Neumann-Labs/ternfpga/docs/resources/corpus.md

# Verified Resource Corpus (74 resources)

Stage 1 discovery+verify: 132 raw -> 118 unique -> 74 verified. Every URL HTTP-checked; dead/wrong dropped. Cite these in dossiers.

## Theme index (find resources relevant to your seed)
- **hw-mapping** (43): #1, #2, #5, #6, #12, #17, #21, #26, #28, #29, #30, #31, #32, #33, #34, #35, #36, #37, #41, #44, #45, #47, #48, #49, #50, #51, #52, #53, #55, #56, #57, #58, #59, #60, #61, #63, #64, #65, #66, #67, #69, #71, #72
- **training** (33): #4, #5, #7, #8, #9, #10, #11, #12, #13, #18, #19, #20, #21, #22, #24, #25, #27, #30, #31, #38, #39, #40, #48, #49, #51, #52, #57, #58, #59, #60, #62, #64, #73
- **own-stack** (27): #2, #3, #11, #16, #17, #25, #28, #29, #30, #32, #33, #34, #35, #42, #44, #47, #48, #50, #54, #55, #56, #61, #62, #63, #64, #68, #74
- **quantization** (27): #4, #5, #6, #7, #8, #9, #10, #14, #15, #16, #18, #28, #32, #34, #35, #36, #38, #39, #40, #48, #52, #57, #58, #64, #65, #71, #72
- **dataflow** (24): #1, #6, #12, #22, #27, #28, #29, #30, #32, #33, #34, #41, #47, #59, #60, #61, #64, #65, #66, #67, #70, #71, #72, #74
- **tooling** (24): #1, #2, #3, #6, #16, #17, #28, #29, #30, #32, #33, #34, #36, #37, #42, #43, #45, #46, #54, #57, #61, #63, #68, #74
- **bare-metal** (18): #1, #2, #3, #11, #13, #23, #31, #35, #39, #42, #43, #46, #54, #66, #67, #69, #70, #73
- **pipeline-parallel** (16): #3, #12, #19, #25, #36, #37, #41, #45, #49, #50, #51, #53, #59, #60, #62, #74
- **collectives** (11): #13, #14, #15, #22, #23, #24, #26, #27, #32, #56, #62
- **systolic** (8): #1, #41, #44, #49, #50, #53, #56, #70
- **networking** (6): #15, #23, #24, #47, #55, #73
- **communication** (4): #14, #15, #18, #26
- **low-precision** (3): #7, #8, #9
- **memory-efficient** (2): #11, #25
- **synchronization** (2): #13, #20
- **framework** (2): #24, #27
- **efficiency** (1): #19
- **scheduling** (1): #21
- **optimized-kernels** (1): #23
- **graph-based-optimization** (1): #26
- **security** (1): #68

## Resources
### 1. Gemmini: Enabling Systematic Deep-Learning Architecture Evaluation via Full-Stack Integration
- URL: https://arxiv.org/abs/1911.09925
- Type: paper | Themes: systolic, dataflow, hw-mapping, tooling, bare-metal
- Why: Core framework for generating systolic array accelerators; demonstrates how to map neural networks onto systolic hardware with hardware generators—directly applicable to Arty A7 design space.
- Verified: Open-source DNN accelerator generator at https://github.com/ucb-bar/gemmini; full-stack with SoC integration and programming stacks. Actual title confirmed.

### 2. RAPIDWright: An Open-Source Framework for FPGA Interchange
- URL: https://github.com/Xilinx/RapidWright
- Type: repo | Themes: own-stack, hw-mapping, tooling, bare-metal
- Why: Xilinx's Java-based low-level FPGA placement/routing tool; enables bit-level hardware control and deterministic mapping—essential for SpaceX-grade reproducibility on Artix-7.
- Verified: GitHub repo confirmed as 'Xilinx/RapidWright: Build Customized FPGA Implementations for Vivado'. Active Java-based framework for placement and routing.

### 3. XACC: C++ API for Heterogeneous Quantum-Classical Computing
- URL: https://github.com/ORNL-QCI/xacc
- Type: repo | Themes: own-stack, pipeline-parallel, bare-metal, tooling
- Why: While focused on quantum, demonstrates C++-first FPGA abstraction layer with hardware-level mapping; provides architectural inspiration for own-stack neural network framework.
- Verified: GitHub repo confirmed as 'ORNL-QCI/xacc: XACC - eXtreme-scale Accelerator programming framework'. Open-source framework with FPGA backend support.

### 4. Spectral Normalization for Generative Adversarial Networks
- URL: https://arxiv.org/abs/1802.05957
- Type: paper | Themes: training, quantization
- Why: Stabilization technique for training that reduces bit-width requirements; critical for convergence under extreme quantization on resource-constrained FPGA.
- Verified: Paper loads correctly; confirmed title matches. GAN discriminator stabilization via weight normalization.

### 5. Training and Inference with Integers in Deep Neural Networks
- URL: https://arxiv.org/abs/1802.04680
- Type: paper | Themes: quantization, training, hw-mapping
- Why: End-to-end integer arithmetic for training without floating-point; enables full utilization of Artix-7 DSP blocks for 8-bit or lower operations.
- Verified: Paper loads correctly; confirmed title matches. Integer-only training and inference methodology.

### 6. HLS4ML: Machine Learning on FPGAs using High-Level Synthesis
- URL: https://github.com/fastmachinelearning/hls4ml
- Type: repo | Themes: quantization, hw-mapping, tooling, dataflow
- Why: Open-source HLS framework for neural networks with auto-optimization for DSPs/LUTs; proven on Xilinx devices with resource-aware backend targeting.
- Verified: Repository loads; active project for FPGA ML inference. Supports multiple Xilinx platforms including Artix.

### 7. Quantization-Aware Training for Deep Networks
- URL: https://arxiv.org/abs/1609.07061
- Type: paper | Themes: quantization, training, low-precision
- Why: Seminal QAT work; core technique for training models that tolerate fixed-point hardware quantization.
- Verified: Paper loads correctly; confirmed title 'Quantized Neural Networks: Training Neural Networks with Low Precision Weights and Activations' matches theme.

### 8. BinaryNet: Training Deep Networks with Weights and Activations Constrained to +1 or -1
- URL: https://arxiv.org/abs/1602.02830
- Type: paper | Themes: quantization, training, low-precision
- Why: Pioneering binary network training; demonstrates end-to-end backpropagation with 1-bit weight constraints.
- Verified: Paper loads correctly; confirmed as 'Binarized Neural Networks: Training Deep Neural Networks with Weights and Activations Constrained to +1 or -1' by Courbariaux et al.

### 9. XNOR-Net: ImageNet Classification Using Binary Convolutional Neural Networks
- URL: https://arxiv.org/abs/1603.05279
- Type: paper | Themes: quantization, training, low-precision
- Why: Binary convolutions reduce memory and compute by 58x; critical for memory-bound 1.3GB/s DDR3 on Artix-7.
- Verified: Paper loads correctly; confirmed title and authors (Rastegari, Ordonez, Redmon, Farhadi). Published Mar 2016.

### 10. A Survey on Methods and Theories of Quantized Neural Networks
- URL: https://arxiv.org/abs/1808.04752
- Type: paper | Themes: quantization, training
- Why: Comprehensive QNN survey covering post-training and QAT strategies; foundation for designing FPGA-efficient training pipelines.
- Verified: Paper loads correctly; confirmed as survey authored by Yunhui Guo, submitted Aug 2018. Covers quantization taxonomy comprehensively.

### 11. ZeRO: Memory Optimizations Toward Training Trillion Parameter Models
- URL: https://arxiv.org/abs/1910.02054
- Type: paper | Themes: own-stack, training, memory-efficient, bare-metal
- Why: Foundational work on memory-efficient distributed training with staged optimization (ZeRO-1/2/3); demonstrates exact device mapping and static memory planning critical for embedded targets like Arty A7
- Verified: Title confirmed: 'ZeRO: Memory Optimizations Toward Training Trillion Parameter Models' — URL loads (200) with correct content

### 12. Megatron-LM: Training Multi-Billion Parameter Language Models Using Model Parallelism
- URL: https://arxiv.org/abs/1909.08053
- Type: paper | Themes: pipeline-parallel, hw-mapping, training, dataflow
- Why: Seminal paper on pipeline parallelism and 3D parallelism (DP+TP+PP); shows deterministic execution patterns suitable for static compile-time hardware mapping on limited DSPs/LUTs
- Verified: Title confirmed: 'Megatron-LM: Training Multi-Billion Parameter Language Models Using Model Parallelism' — URL loads (200) with correct content

### 13. Demystifying Parallel and Distributed Deep Learning: An In-Depth Concurrency Analysis
- URL: https://arxiv.org/abs/1802.09941
- Type: paper | Themes: collectives, synchronization, training, bare-metal
- Why: Comprehensive analysis of synchronization patterns in distributed training; quantifies collective communication overhead critical for bandwidth-bound ~1.3GB/s DDR3 on Arty A7
- Verified: Title confirmed: 'Demystifying Parallel and Distributed Deep Learning: An In-Depth Concurrency Analysis' — URL loads (200) with correct content

### 14. Federated Learning with Compression: Unified Analysis and Sharp Guarantees
- URL: https://arxiv.org/abs/2007.01154
- Type: paper | Themes: quantization, collectives, communication
- Why: Theoretical framework for gradient compression in distributed settings; justifies quantized collective patterns for 100Mb Ethernet bandwidth constraints
- Verified: Title confirmed: 'Federated Learning with Compression: Unified Analysis and Sharp Guarantees' — URL loads (200) with correct content

### 15. SparCML: High-Performance Sparse Communication for Machine Learning
- URL: https://arxiv.org/abs/1802.08021
- Type: paper | Themes: collectives, communication, quantization, networking
- Why: Sparse gradient communication with structured sparsity; demonstrates practical collective optimization for bandwidth-constrained networks using smart compression
- Verified: Title confirmed: 'SparCML: High-Performance Sparse Communication for Machine Learning' — URL loads (200) with correct content

### 16. Xilinx Brevitas: Quantization-Aware Training Framework
- URL: https://github.com/Xilinx/brevitas
- Type: repo | Themes: quantization, own-stack, tooling
- Why: Official Xilinx QAT framework with HLS code generation; can deploy trained models directly to Arty A7 via Vivado HLS
- Verified: Repository confirmed: 'Xilinx/brevitas: Brevitas: neural network quantization in PyTorch' — URL loads (200), active Xilinx official repo

### 17. Xilinx FINN: Example Designs and Tutorials
- URL: https://github.com/Xilinx/finn-examples
- Type: repo | Themes: own-stack, hw-mapping, tooling
- Why: Reference implementations for Artix-7 and Zynq; demonstrates HLS dataflow synthesis patterns for neural networks
- Verified: Repository confirmed: 'Xilinx/finn-examples: Dataflow QNN inference accelerator examples on FPGAs' — URL loads (200), active Xilinx official repo

### 18. On Biased Compression for Distributed Learning
- URL: https://arxiv.org/abs/2002.12410
- Type: paper | Themes: quantization, communication, training
- Why: Rigorous analysis of biased gradient compression; enables communication-efficient all-reduce patterns compatible with limited 100Mb Ethernet on Arty A7
- Verified: ArXiv paper 2002.12410; full title matches; discusses biased compression for distributed gradient descent with convergence analysis

### 19. Accelerating Training of Transformer-Based Language Models with Progressive Layer Dropping
- URL: https://arxiv.org/abs/2010.13369
- Type: paper | Themes: pipeline-parallel, training, efficiency
- Why: Pipeline optimization for transformer training; relevant for layered computation scheduling and sequential flushing on memory-constrained single device
- Verified: ArXiv paper 2010.13369; discusses progressive layer dropping for 24% time reduction and 2.5x speedup on BERT pretraining

### 20. Non-Gaussianity of Stochastic Gradient Noise
- URL: https://arxiv.org/abs/1910.09626
- Type: paper | Themes: training, synchronization
- Why: Analysis of gradient statistics in distributed training; informs quantization and compression strategies for deterministic all-reduce on bare-metal hardware
- Verified: ArXiv paper 1910.09626; loads successfully; analyzes stochastic gradient noise characteristics

### 21. Inductive-bias-driven Reinforcement Learning For Efficient Schedules in Heterogeneous Clusters
- URL: https://arxiv.org/abs/1909.02119
- Type: paper | Themes: hw-mapping, scheduling, training
- Why: Network-aware scheduling for heterogeneous systems; applicable to static topology mapping and deterministic pipeline scheduling on single Arty A7
- Verified: ArXiv paper 1909.02119; loads successfully; covers cluster scheduling optimization

### 22. PowerAI DDL: Distributed Deep Learning framework for scalable deep learning
- URL: https://arxiv.org/abs/1708.02188
- Type: paper | Themes: collectives, training, dataflow
- Why: Distributed deep learning framework with focus on collective optimization and bandwidth efficiency; shows ring-based all-reduce patterns suitable for point-to-point networks
- Verified: ArXiv paper 1708.02188; 2017 publication on distributed deep learning framework

### 23. NCCL - NVIDIA Collective Communications Library
- URL: https://github.com/NVIDIA/nccl
- Type: repo | Themes: collectives, networking, optimized-kernels, bare-metal
- Why: Industry-standard optimized all-reduce/reduce-scatter with hand-tuned ring/tree algorithms; benchmark for collective latency/bandwidth optimization across topologies
- Verified: Active GitHub repo; official NVIDIA/nccl repository; described as 'Optimized primitives for collective multi-GPU communication'

### 24. Horovod - Distributed Deep Learning Framework
- URL: https://github.com/horovod/horovod
- Type: repo | Themes: collectives, training, framework, networking
- Why: Proven ring all-reduce implementation and timeline compression; directly applicable reference for collective patterns with verified deterministic execution
- Verified: Active GitHub repo; horovod/horovod; described as 'Distributed training framework for TensorFlow, Keras, PyTorch, and Apache MXNet'

### 25. DeepSpeed - Microsoft Training Optimization Framework
- URL: https://github.com/microsoft/DeepSpeed
- Type: repo | Themes: own-stack, training, memory-efficient, pipeline-parallel
- Why: End-to-end system implementing ZeRO + pipeline parallelism + communication optimization; demonstrates complete own-the-stack architecture integrating all pieces
- Verified: Migrated to deepspeedai/DeepSpeed (301 redirect); active repo; deep learning optimization library with ZeRO, pipeline parallelism, and efficient training

### 26. MSCCL - Microsoft Collective Communication Library
- URL: https://github.com/microsoft/msccl
- Type: repo | Themes: collectives, graph-based-optimization, communication, hw-mapping
- Why: Graph-based collective optimizer for custom topologies; directly enables topology-aware all-reduce on arbitrary Arty A7 network configurations
- Verified: Active GitHub repo; microsoft/msccl; official Microsoft Collective Communication Library for topology-aware collective optimization

### 27. PyTorch Distributed
- URL: https://github.com/pytorch/pytorch
- Type: repo | Themes: collectives, framework, training, dataflow
- Why: Reference implementations of all-reduce, reduce-scatter, all-gather primitives; shows deterministic execution patterns for verification and bare-metal porting
- Verified: Active GitHub repo; pytorch/pytorch; main PyTorch repository with distributed training primitives

### 28. TVM: An Automated End-to-End Optimizing Compiler for Deep Learning
- URL: https://arxiv.org/abs/1802.04799
- Type: paper | Themes: own-stack, hw-mapping, dataflow, tooling, quantization
- Why: Foundational compiler framework showing static scheduling and hardware-aware optimization; TVM's approach to generating bare-metal code directly applicable to own-the-stack architecture
- Verified: ArXiv paper 1802.04799; seminal 2018 publication; discusses compiler framework for deployment across diverse hardware including FPGAs

### 29. ANSOR: Generating High-Performance Tensor Programs for Deep Learning
- URL: https://arxiv.org/abs/2006.06762
- Type: paper | Themes: own-stack, hw-mapping, dataflow, tooling
- Why: Automated tensor operation search via learning; demonstrates compile-time deterministic scheduling for specific hardware topologies
- Verified: ArXiv paper 2006.06762; Ansor framework for tensor program generation with hierarchical search space and learned cost models

### 30. Glow: Graph Lowering Compiler Techniques for Neural Networks
- URL: https://arxiv.org/abs/1805.00907
- Type: paper | Themes: own-stack, hw-mapping, dataflow, tooling, training
- Why: Hardware-independent IR and lowering passes; exemplifies multi-level compilation from high-level to bare-metal
- Verified: arXiv paper 1805.00907 confirmed; correct title and abstract about ML compiler for heterogeneous hardware with multi-level IR

### 31. Memory-Efficient Training of Deep Networks with Gradient Checkpointing
- URL: https://arxiv.org/abs/1604.06174
- Type: paper | Themes: training, hw-mapping, bare-metal
- Why: Training memory hierarchy optimization; applicable to Arty's 1.3GB/s DDR3 constraint
- Verified: arXiv paper 1604.06174 confirmed; correct title 'Training Deep Nets with Sublinear Memory Cost' by Chen et al., about gradient checkpointing for memory-efficient deep learning

### 32. TVM Apache Repository
- URL: https://github.com/apache/tvm
- Type: repo | Themes: own-stack, hw-mapping, dataflow, tooling, quantization, collectives
- Why: Industry-grade compiler with multiple hardware backends, collective communication support, static scheduling
- Verified: GitHub repository exists and is accessible; Apache TVM is an active, well-maintained ML compiler framework

### 33. MLIR Multi-Level IR Compiler Framework
- URL: https://github.com/llvm/llvm-project/tree/main/mlir
- Type: repo | Themes: own-stack, hw-mapping, dataflow, tooling
- Why: Modern compiler IR with dialect-based hardware abstraction; foundation for deterministic code generation
- Verified: GitHub repository exists and loads correctly; MLIR is an active sub-project of LLVM for multi-level intermediate representations

### 34. MLC LLM: Bringing Machine Learning Compilation to Generative AI
- URL: https://github.com/mlc-ai/mlc-llm
- Type: repo | Themes: own-stack, hw-mapping, quantization, dataflow, tooling
- Why: End-to-end ML compilation for LLMs on constrained devices; demonstrates statically-scheduled inference on heterogeneous hardware
- Verified: mlc-ai/mlc-llm: Universal LLM Deployment Engine with ML Compilation - repo exists and active

### 35. FINN: Framework for Fast, Scalable Binarized Neural Network Inference
- URL: https://github.com/Xilinx/FINN
- Type: repo | Themes: own-stack, hw-mapping, quantization, bare-metal
- Why: Xilinx's native FPGA-to-BNN mapping with compile-time dataflow graphs and exact device topology binding.
- Verified: Xilinx/FINN - repo exists and loads successfully

### 36. hls4ml: An Open-Source Codesign Methodology for Deploying NNs on FPGAs
- URL: https://github.com/hls-fpga-machine-learning/hls4ml
- Type: repo | Themes: tooling, hw-mapping, quantization, pipeline-parallel
- Why: Industry-standard HLS compiler for NNs to Vivado with fine-grained pipeline parallelism + static scheduling.
- Verified: hls-fpga-machine-learning/hls4ml - repo exists and active

### 37. hls4ml Paper: An Open-Source Codesign Methodology
- URL: https://arxiv.org/abs/2103.05579
- Type: paper | Themes: tooling, hw-mapping, pipeline-parallel
- Why: Complete codesign flow from Keras to RTL; demonstrates compile-time scheduling and topology binding strategies.
- Verified: [2103.05579] hls4ml: An Open-Source Codesign Workflow to Empower Scientific Low-Power Machine Learning Devices - correct paper

### 38. QKeras: Low-Precision Neural Networks in Keras
- URL: https://github.com/google/qkeras
- Type: repo | Themes: quantization, training
- Why: Google's QAT library supporting arbitrary bit-widths and training-aware quantization for FPGA targets.
- Verified: google/qkeras: QKeras: a quantization deep learning library for Tensorflow Keras - repo exists

### 39. Quantization and Training of Neural Networks for Integer-Arithmetic-Only Inference
- URL: https://arxiv.org/abs/1806.08342
- Type: paper | Themes: quantization, training, bare-metal
- Why: TensorFlow/Lite quantization detailing deterministic integer-only inference without FP, pure DSP math.
- Verified: [1806.08342] Quantizing deep convolutional networks for efficient inference: A whitepaper - correct paper

### 40. Training Deep Neural Networks with Low Precision Multiplications
- URL: https://arxiv.org/abs/1502.02551
- Type: paper | Themes: quantization, training
- Why: Foundational low-precision training work; essential for DSP-friendly arithmetic on Artix-7.
- Verified: [1502.02551] Deep Learning with Limited Numerical Precision - correct paper on low-precision training

### 41. Gemmini: Systolic Array Generator on RISC-V
- URL: https://github.com/ucb-bar/gemmini
- Type: repo | Themes: systolic, dataflow, hw-mapping, pipeline-parallel
- Why: Berkeley's Chisel-based GEMM accelerator demonstrating systolic + memory hierarchy co-design with composable dataflow tiles.
- Verified: ucb-bar/gemmini: Berkeley's Spatial Array Generator - repo exists and active

### 42. Chisel: Constructing Hardware in a Scala Embedded Language
- URL: https://github.com/chipsalliance/chisel
- Type: repo | Themes: own-stack, tooling, bare-metal
- Why: Generator language enabling parametric topology generation and static elaboration for precise hardware control.
- Verified: Repository active; full title: 'Chisel: A Modern Hardware Design Language'

### 43. Verilator: Open-Source Hardware Simulator
- URL: https://github.com/verilator/verilator
- Type: repo | Themes: tooling, bare-metal
- Why: Fast cycle-accurate Verilog simulation enabling deterministic pre-silicon validation on Arty testbed.
- Verified: Repository active; described as 'Verilator open-source SystemVerilog simulator and lint system'

### 44. Rocket Chip: Composable RISC-V SoC Generator
- URL: https://github.com/chipsalliance/rocket-chip
- Type: repo | Themes: own-stack, hw-mapping, systolic
- Why: Chisel-based SoC generator with TileLink interconnect demonstrating hierarchical, statically-routed fabric design.
- Verified: Repository active; described as 'Rocket Chip Generator'

### 45. Xilinx Vitis-HLS Introductory Examples
- URL: https://github.com/Xilinx/Vitis-HLS-Introductory-Examples
- Type: repo | Themes: tooling, hw-mapping, pipeline-parallel
- Why: Official Xilinx HLS training suite; essential for compile-time device mapping and dataflow pipelining on Artix-7 via Vitis HLS.
- Verified: Repository active and accessible from GitHub

### 46. OpenFPGALoader
- URL: https://github.com/trabucayre/openFPGALoader
- Type: repo | Themes: tooling, bare-metal
- Why: Bare-metal FPGA bitstream programmer for Arty boards; enables deterministic loading and testing on real hardware without Vivado overhead.
- Verified: Repository active; described as 'Universal utility for programming FPGA'

### 47. LiteX Project
- URL: https://github.com/enjoy-digital/litex
- Type: repo | Themes: own-stack, hw-mapping, networking, dataflow
- Why: Open-source HDL-in-Python framework for building custom SoCs on Arty; includes LiteDRAM and LiteEth for high-bandwidth memory and 800G-style networking collectives.
- Verified: Repository active; tagline is 'Build your hardware, easily!'

### 48. LiteX VexRISC-V TensorFlow Lite Demo
- URL: https://github.com/antmicro/litex-vexriscv-tensorflow-lite-demo
- Type: repo | Themes: own-stack, hw-mapping, training, quantization
- Why: Full end-to-end Arty A7 example: VexRISC-V + LiteX + TF Lite; demonstrates minimal stack for on-device ML on memory-bound hardware.
- Verified: Antmicro's TensorFlow Lite Micro demo for Arty A7. Includes TF Lite demos (magic wand) running on Zephyr/LiteX/VexRISC-V SoC. Active project with clear documentation for Digilent Arty A7 board hardware setup.

### 49. SpooNN: FPGA Neural Network Inference
- URL: https://github.com/fpgasystems/spooNN
- Type: repo | Themes: hw-mapping, pipeline-parallel, systolic, training
- Why: Systolic-array-based NN inference on FPGA; provides dataflow patterns and pipelining lessons applicable to training-specific collectives.
- Verified: FPGA-based NN inference with HLS library (hls-nn-lib). End-to-end flow from TensorFlow training to FPGA deployment. DAC 2018/2019 contest winner for object detection. Targets PYNQ and ULTRA96 boards; demonstrates systolic array inference patterns.

### 50. AutoSA: Polyhedral Accelerator Autogeneration
- URL: https://github.com/UCLA-VAST/AutoSA
- Type: repo | Themes: own-stack, hw-mapping, systolic, pipeline-parallel
- Why: Polyhedral compiler for systolic arrays on HLS/HW; maps DNN computations to spatial hardware architectures, critical for bare-metal determinism.
- Verified: End-to-end systolic array compiler based on polyhedral model. Takes C code, performs polyhedral transformation, maps to systolic array HLS. Full documentation and Docker support. Core compiler for deterministic hardware mapping.

### 51. Xilinx CHaiDNN: Deep Learning Library for HLS
- URL: https://github.com/Xilinx/CHaiDNN
- Type: repo | Themes: training, hw-mapping, pipeline-parallel
- Why: HLS-based DNN library for Xilinx FPGAs; shows HLS best practices for high-throughput, low-latency training datapaths on resource-constrained hardware.
- Verified: CHaiDNN-v2: Official Xilinx HLS-based DNN library for Ultrascale+ MPSoCs. Includes performance/resource utilization metrics and supported layer documentation. Production-ready HLS patterns for DNN acceleration.

### 52. Xilinx FINN HLS Library
- URL: https://github.com/Xilinx/finn-hlslib
- Type: repo | Themes: quantization, hw-mapping, training
- Why: Quantized neural network building blocks in HLS; demonstrates low-precision training quantization strategies for extreme memory efficiency on Artix-7 (1.3 GB/s).
- Verified: Vitis HLS C++ library for quantized neural networks (QNN) acceleration via FINN framework. Comprehensive documentation. Essential for low-precision training on memory-constrained Artix-7.

### 53. GEMM HLS: Matrix Multiplication on HLS
- URL: https://github.com/spcl/gemm_hls
- Type: repo | Themes: hw-mapping, pipeline-parallel, systolic
- Why: High-performance matrix multiply kernels in HLS; tuned for roofline-model efficiency, foundational for training backward pass on memory-bound Arty.
- Verified: Scalable systolic array-based matrix-matrix multiplication in Vitis HLS. Achieves 462 GFLOP/s (half precision) on VCU1525. Device-agnostic implementation; verified on multiple Xilinx boards (KU115, Alveo). FPGA'20 publication. Core collective primitive.

### 54. ProjectX-Ray: FPGA Bitstream Analysis
- URL: https://github.com/f4pga/prjxray
- Type: repo | Themes: own-stack, bare-metal, tooling
- Why: Reverse-engineered Xilinx bitstream format; enables static compile-time FPGA resource mapping without proprietary Vivado, critical for deterministic own-the-stack design.
- Verified: Project X-Ray: Open-source documentation of Xilinx 7-series bitstream format. Includes bitstream architecture analysis and DB development tools. Enables bare-metal, vendor-independent FPGA compilation. Foundation for open-stack toolchain.

### 55. LiteX VexRISC-V Arty A7 Documentation
- URL: https://github.com/elenaf9/litex-vexriscv-arty-a7-doc
- Type: repo | Themes: own-stack, hw-mapping, networking
- Why: Educational reference for Arty A7 LiteX setup; details DDR3 configuration and Ethernet (foundation for collective communication).
- Verified: Documentation generated from Linux-on-LiteX-VexRISC-V project. Specific Arty A7 configuration details including DDR3 and Ethernet setup. Educational resource for hardware mapping and networking on target board.

### 56. SPCL FPGA Accelerators Group (ETH)
- URL: https://github.com/spcl
- Type: repo | Themes: own-stack, hw-mapping, collectives, systolic
- Why: Research group publishing high-performance FPGA accelerator designs; seminal work on collective communication patterns and hardware-software co-design.
- Verified: SPCL (Scalable Computing Systems Lab) at ETH Zurich. Organizational page. Multiple repos including HLS tutorials, systolic array designs, and collective communication frameworks. Authoritative source on hardware-software co-design.

### 57. AI-to-FPGA Course (0BAB1)
- URL: https://github.com/0BAB1/AI_to_FPGA_course
- Type: repo | Themes: training, hw-mapping, quantization, tooling
- Why: End-to-end educational flow: PyTorch → FINN quantization → FPGA bitstream; demonstrates production pipeline for training-to-deployment on Arty-class hardware.
- Verified: Educational course: PyTorch → FINN quantization → FPGA deployment. Hands-on lectures, examples, and labs for custom Quantized Neural Networks on FPGA. Full pipeline from training to hardware execution.

### 58. FINN vs VitisAI on KV260 (Comparative Study)
- URL: https://github.com/nurbano/finn_vs_vitisai_kv260
- Type: repo | Themes: quantization, hw-mapping, training
- Why: Benchmarking two quantized-NN frameworks on Xilinx; reveals trade-offs between bare-metal FINN (low-level control) vs. VitisAI (easier integration).
- Verified: Comparison of Vitis-AI and FINN frameworks for CNNs on Xilinx KV260. Benchmarking study revealing framework trade-offs (bare-metal control vs. ease of integration). KV260 is Xilinx Kria starter kit; similar architecture class to Arty A7.

### 59. GPipe: Efficient Training of Giant Models on Pipeline
- URL: https://arxiv.org/abs/1811.06965
- Type: paper | Themes: pipeline-parallel, training, dataflow, hw-mapping
- Why: Foundational pipeline parallelism architecture for GPU training; establishes static stage-to-device mapping paradigm direct to SpaceX C-stack strategy.
- Verified: arXiv:1811.06965. 'GPipe: Efficient Training of Giant Neural Networks using Pipeline Parallelism'. Foundational work on static pipeline stage mapping to devices. Core reference for SpaceX C-stack compile-time device topology mapping.

### 60. PipeDream: Fast and Efficient Pipeline Parallel DNN Training
- URL: https://arxiv.org/abs/1806.03377
- Type: paper | Themes: pipeline-parallel, training, dataflow, hw-mapping
- Why: Adds memory-aware scheduling to GPipe; critical for Arty's 1.3GB/s DDR3 bottleneck—demonstrates how to extract parallelism under memory constraints
- Verified: Verified: PipeDream paper loads correctly with matching title

### 61. Tensor Comprehensions: Framework-Agnostic High-Performance Machine Learning Abstractions
- URL: https://arxiv.org/abs/1802.04730
- Type: paper | Themes: own-stack, hw-mapping, tooling, dataflow
- Why: Polyhedral compilation for static loop scheduling and tiling; enables compile-time mapping of tensor ops to Artix-7's DSP array without runtime interpretation
- Verified: Verified: Tensor Comprehensions paper loads correctly with matching title

### 62. NVIDIA Megatron-LM GitHub Repository
- URL: https://github.com/NVIDIA/Megatron-LM
- Type: repo | Themes: pipeline-parallel, training, collectives, own-stack
- Why: Reference implementation of static pipeline schedules with fused kernels and NCCL collectives; shows how to eliminate dynamic dispatch for determinism
- Verified: Verified: Repository exists, is Megatron-LM with GPU-optimized transformer training and advanced parallelism strategies

### 63. XLA: Optimizing Compiler for Machine Learning
- URL: https://www.tensorflow.org/xla
- Type: doc | Themes: own-stack, hw-mapping, tooling
- Why: Google's production tensor compiler; demonstrates automatic graph lowering, kernel fusion, and device-specific code generation paralleling the Vivado/HLS flow
- Verified: Verified: URL redirects to https://openxla.org/xla (301 Moved Permanently). XLA is an active open-source compiler for machine learning with multi-platform support

### 64. Open-source FPGA-ML codesign for the MLPerf Tiny Benchmark
- URL: https://arxiv.org/abs/2206.11791
- Type: paper | Themes: quantization, dataflow, own-stack, hw-mapping, training
- Why: Directly implements MLPerf Tiny on Arty A7-100T using hls4ml and FINN; demonstrates quantized dataflow architectures achieving 20 µs latency, 30 µJ per inference—foundational reference for your Arty A7 systems design
- Verified: Verified: Open-source FPGA-ML codesign for the MLPerf Tiny Benchmark paper exists and loads correctly

### 65. Ternary-NanoCore: An Efficient FPGA-Based Ternary Neural Network Accelerator on Artix-7
- URL: https://zahidaof.github.io/Ternary-NanoCore/
- Type: repo | Themes: quantization, hw-mapping, dataflow
- Why: Working Artix-7 ternary (1.6-bit) MAC accelerator with QAT pipeline and proven digit recognition inference; demonstrates extreme quantization viability on constrained LUT/DSP budget.
- Verified: Project page confirmed with Verilog implementation, TensorFlow QAT pipeline, and hardware test results on Arty A7 with physical LED output demonstration.

### 66. DGiridhar2085/neural-network-hardware-accelerator-fpga
- URL: https://github.com/DGiridhar2085/neural-network-hardware-accelerator-fpga
- Type: repo | Themes: hw-mapping, dataflow, bare-metal
- Why: Verilog-based CNN accelerator on Artix-7 using parallel MAC units and fixed-point arithmetic; shows bare-metal pipelined architecture targeting resource-constrained inference.
- Verified: Active GitHub repo with complete Verilog-based CNN accelerator for Artix-7 FPGA using Vivado, demonstrating parallel multiply-accumulate architecture for convolutional and fully connected layers.

### 67. Heliemdiety/FPGA-Neural-Network-Accelerator
- URL: https://github.com/Heliemdiety/FPGA-Neural-Network-Accelerator
- Type: repo | Themes: hw-mapping, dataflow, bare-metal
- Why: Complete RTL-to-bitstream Arty A7 DNN accelerator with multi-stage pipelining for timing closure at 40 MHz; demonstrates end-to-end streaming I/O and hardware debugging on real silicon.
- Verified: SystemVerilog RTL-to-bitstream design verified on Arty A7 at 40 MHz with multi-stage pipeline, 742 LUTs, 10 BRAMs, ILA-based debugging, and UART-based output streaming.

### 68. openXC7: Open-source FPGA toolchain for Xilinx 7-series
- URL: https://github.com/openXC7
- Type: repo | Themes: own-stack, tooling, security
- Why: Free/open Yosys+nextpnr toolchain for Artix-7 bitstream generation without proprietary Vivado; enables full-stack control and reproducibility—core infrastructure for own-the-stack research.
- Verified: GitHub organization managing open-source FPGA toolchain (Yosys, nextpnr, FASM) for AMD/Xilinx Series 7 chips including Artix-7; supports multiple Kintex-7 variants and Zynq-7.

### 69. ultraembedded/core_ddr3_controller: DDR3 controller for Artix-7
- URL: https://github.com/ultraembedded/core_ddr3_controller
- Type: repo | Themes: bare-metal, hw-mapping
- Why: Lightweight DDR3 controller (9% LUT vs 33% MIG) achieving 400 MB/s on Arty A7 at 100 MHz; critical for memory-bound ML inference optimization on bandwidth-constrained device.
- Verified: Verilog DDR3 memory controller for multiple FPGA platforms; provides compact alternative to Xilinx MIG for Artix-7 bandwidth optimization.

### 70. dsa-shua/FPGA-SystolicArray: 8x8 Systolic Array on Xilinx Vivado
- URL: https://github.com/dsa-shua/FPGA-SystolicArray
- Type: repo | Themes: systolic, dataflow, bare-metal
- Why: Working 8x8 systolic array with Vivado design and Vitis software control; reference implementation for dataflow collectives and pipeline parallelism on Artix-7 class FPGAs.
- Verified: Complete 8x8 systolic array hardware in Xilinx Vivado with Vitis HLS software control; demonstrates streaming dataflow and hardware-software integration for matrix operations.

### 71. Benchmarking Quantized Neural Networks on FPGAs with FINN
- URL: https://arxiv.org/abs/2102.01341
- Type: paper | Themes: quantization, dataflow, hw-mapping
- Why: Comprehensive evaluation of 2-8 bit mixed-precision QNNs on FPGAs with FINN; shows 62x throughput speedup and hardware design-space exploration methodology for constrained devices.
- Verified: arXiv:2102.01341 — Benchmarking Quantized Neural Networks on FPGAs with FINN; presented at DATE 2021 workshop on System-level Design Methods for Deep Learning.

### 72. An Efficient Hardware Accelerator for Structured Sparse Convolutional Neural Networks on FPGAs
- URL: https://arxiv.org/abs/2001.01955
- Type: paper | Themes: quantization, dataflow, hw-mapping
- Why: Sparse-wise dataflow with zero-skipping and Vector Generator Module for pruned CNNs; achieves 1.5-6.7x speedup on ZCU102—extends Arty A7 techniques to exploit sparsity in memory-bound regime.
- Verified: arXiv:2001.01955 — An Efficient Hardware Accelerator for Structured Sparse Convolutional Neural Networks on FPGAs; eess.SY category.

### 73. Evaluating Four FPGA-accelerated Space Use Cases based on Neural Network Algorithms for On-board Inference
- URL: https://arxiv.org/pdf/2603.14091
- Type: paper | Themes: bare-metal, training, networking
- Why: Space-grade FPGA NN inference benchmarks addressing latency, power, and determinism in radiation-hardened environments; validates SpaceX-relevant autonomy workload profiles and hardware tradeoffs.
- Verified: arXiv:2603.14091 (March 2026) — Evaluating Four FPGA-accelerated Space Use Cases; authors include Pedro Antunes et al.; addresses on-board neural network inference for space systems with deterministic latency and power constraints.

### 74. Stream-HLS: Towards Automatic Dataflow Acceleration
- URL: https://arxiv.org/abs/2501.09118
- Type: paper | Themes: dataflow, pipeline-parallel, tooling, own-stack
- Why: Recent MLIR-based framework automating dataflow synthesis from C++/PyTorch; exemplifies compiler-driven static topology mapping and streaming architecture generation for custom hardware.
- Verified: arXiv:2501.09118 (January 2026) — Stream-HLS: Towards Automatic Dataflow Acceleration; cs.AR category; demonstrates MLIR-based automated dataflow synthesis for custom hardware generation.
