Neumann-Labs/ternfpga/bench/plots/ddr3_roofline.png

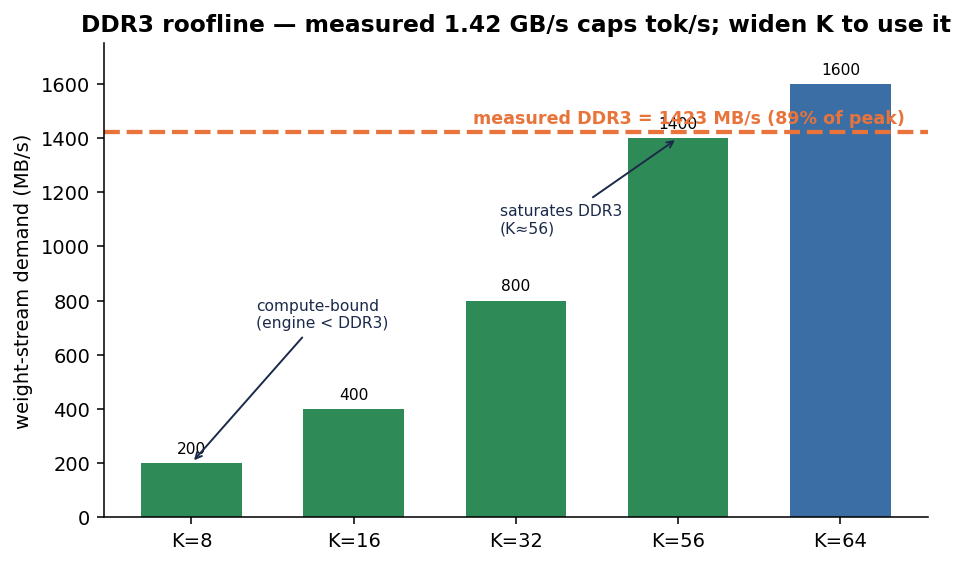
bench/plots/ddr3_roofline.png
