Neumann-Labs/ternfpga/bench/plots/ffn_block_energy.png

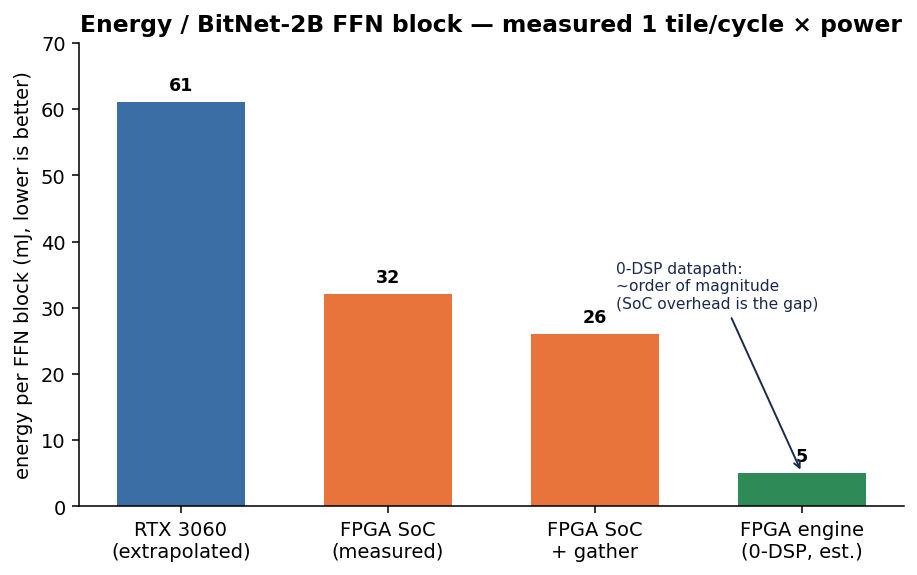
bench/plots/ffn_block_energy.png
