Neumann-Labs/ternfpga/bench/plots/full_model_energy.png

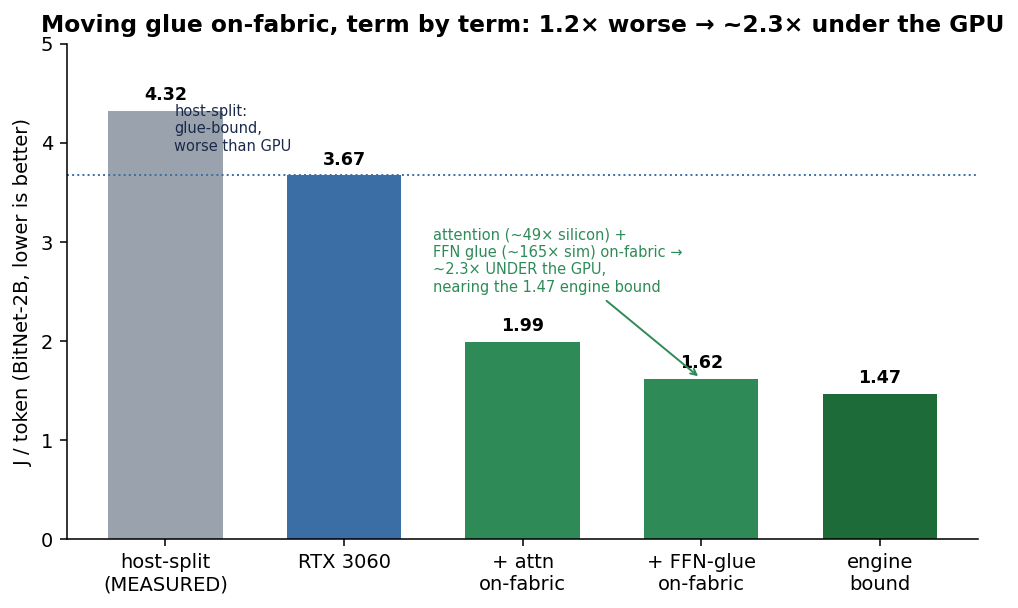
bench/plots/full_model_energy.png
