Neumann-Labs/ternfpga/bench/plots/gather_savings.png

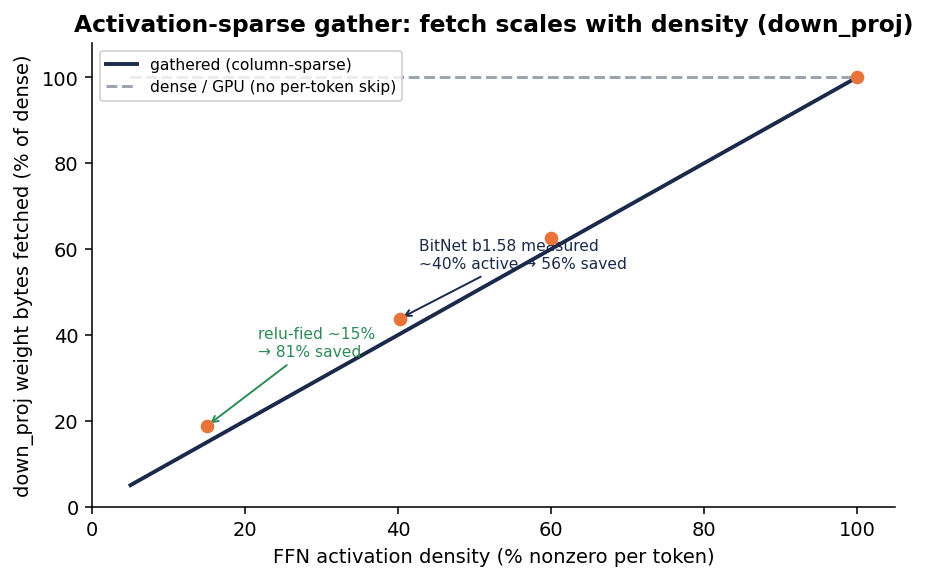
bench/plots/gather_savings.png
