Neumann-Labs/ternfpga/bench/plots/sparsity_compare.png

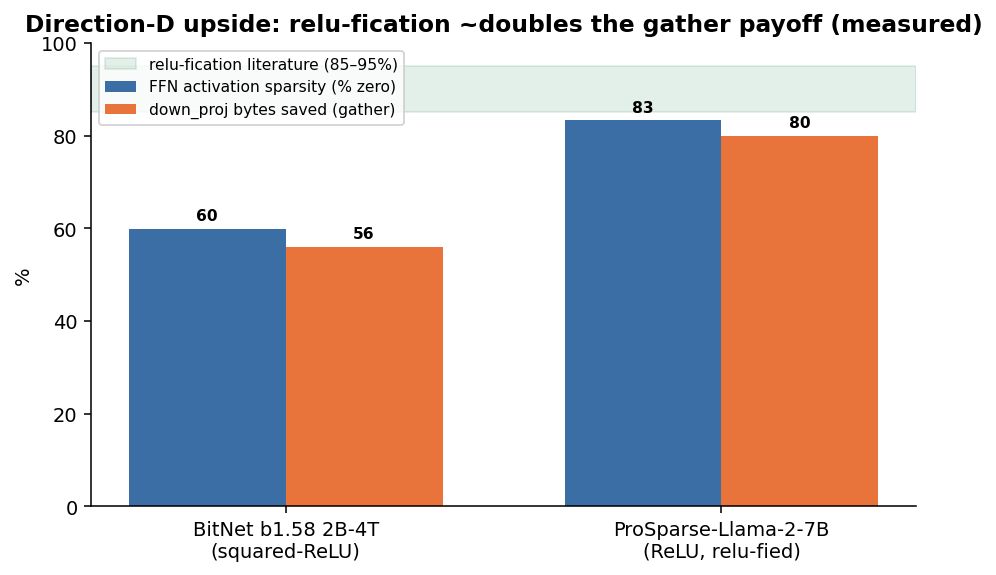
bench/plots/sparsity_compare.png
