Neumann-Labs/ternfpga/bench/plots/sparsity_structure.png

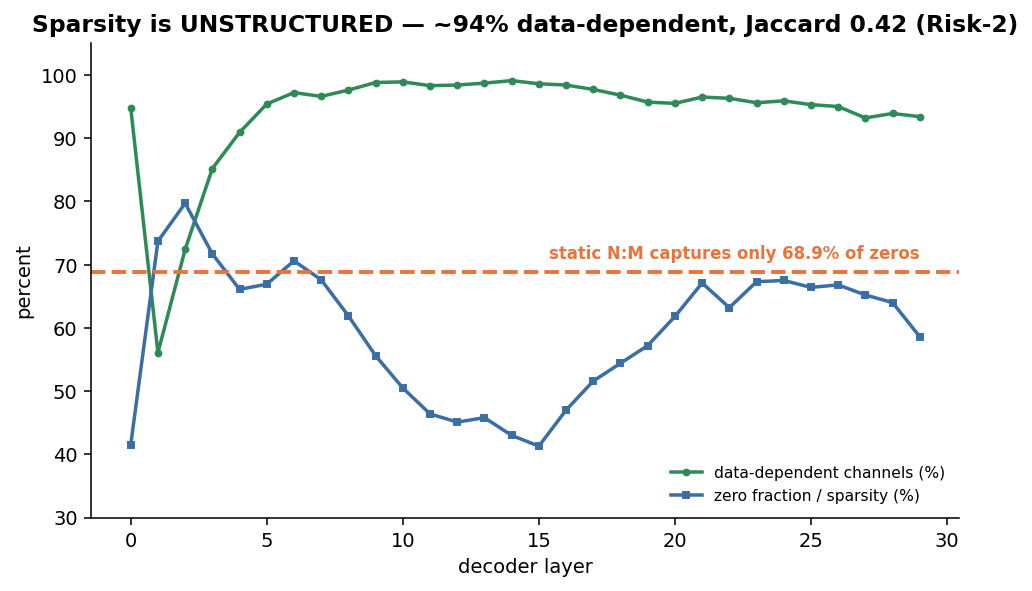
bench/plots/sparsity_structure.png
