Neumann-Labs/ternfpga/bench/plots/bram_fix.png

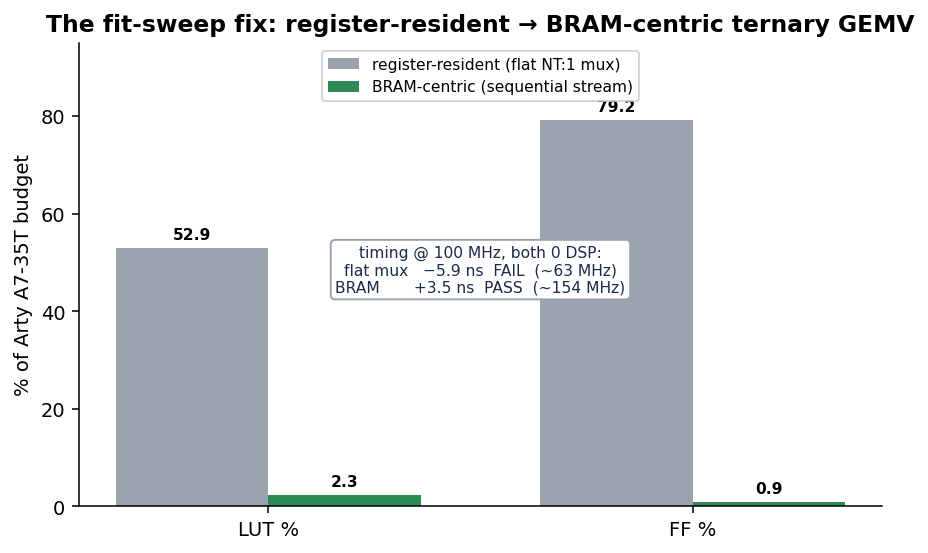
bench/plots/bram_fix.png
