Neumann-Labs/ternfpga/constraints/arty_a7_35.xdc

## Arty A7-35T constraints for arty_top (subset of the Digilent master XDC).

## 100 MHz system clock
set_property -dict { PACKAGE_PIN E3  IOSTANDARD LVCMOS33 } [get_ports { CLK100MHZ }];
create_clock -add -name sys_clk_pin -period 10.00 -waveform {0 5} [get_ports { CLK100MHZ }];

## Green LEDs LD4..LD7
set_property -dict { PACKAGE_PIN H5  IOSTANDARD LVCMOS33 } [get_ports { led[0] }];
set_property -dict { PACKAGE_PIN J5  IOSTANDARD LVCMOS33 } [get_ports { led[1] }];
set_property -dict { PACKAGE_PIN T9  IOSTANDARD LVCMOS33 } [get_ports { led[2] }];
set_property -dict { PACKAGE_PIN T10 IOSTANDARD LVCMOS33 } [get_ports { led[3] }];

## USB-UART bridge: FPGA transmit -> host (uart_rxd_out = D10)
set_property -dict { PACKAGE_PIN D10 IOSTANDARD LVCMOS33 } [get_ports { uart_tx_o }];

## Configuration / bitstream settings
set_property CFGBVS VCCO        [current_design]
set_property CONFIG_VOLTAGE 3.3 [current_design]
