Neumann-Labs/ternfpga/(commit log)

2026-06-08 feat(rtl): row-streamed ternary GEMV + scalable cocotb suite
    Adds ternary_gemv (y=W*x, one weight row/cycle via the ternary_dot lane, results via a narrow rd_addr/rd_data port) with a bit-exact cocotb testbench (60 random K=8/M=16 cases vs numpy golden). Replaces the experimental cocotb.runner (which cannot bind a submodule-instantiating top on Verilator 5.020) with a per-DUT Makefile.sim flow. Adds docs/ARCHITECTURE.md. Both ternary_dot and ternary_gemv pass bit-exact.
    [ternary_gemv.sv]
2026-06-08 feat(rtl): activation-sparse ternary GEMV gather engine (Direction D)
    ternary_gemv_sparse: FSM gather engine that fetches ONLY active rows from weight memory (mask-driven), skipping inactive neurons entirely - the mechanism by which activation sparsity cuts DDR3 traffic. Test-first cocotb tb vs numpy golden, with a sync-read weight-ROM model. Measured weight-byte savings: 50%/75%/93.8% at 50%/25%/6% density; rows_fetched == active rows exactly, output bit-exact. Adds bench/results/sparse_skip_sim.md; updates ARCHITECTURE, README, BUILDLOG. Full suite (dot+gemv+sparse) green.
    [ternary_gemv_sparse.sv]
2026-06-08 syn: OOC Vivado synthesis — 0 DSPs confirmed on xc7a35t (104-116 MHz)
    syn/{run_synth.sh,synth_one.tcl}: out-of-context Vivado 2025.2 synthesis on the real Arty A7-35T part. All three modules (ternary_dot/gemv/sparse) use 0 DSP48 — the multiply path is pure LUT sign-select + CARRY4, silicon-validating the central claim. <2.5% LUTs, 0 BRAM, ~104-116 MHz unpipelined v0 (synth estimate; pipelining + PnR are Phase 1). Results in bench/results/utilization.md; updates BUILDLOG, README.
2026-06-08 feat(rtl): pipelined ternary dot — Fmax 104→280 MHz, still 0 DSP
    ternary_dot_pipe: 3-stage registered reduction (sign-select, two half-sums, final sum), streaming 1 result/cycle with valid_in->valid_out. tb_ternary_dot_pipe.py: 800 streamed dots bit-exact, FIFO-tracked. Synth (xc7a35t): 4 logic levels (was ~14), WNS +0.424ns@4ns -> ~280MHz (2.7x the combinational GEMV), 149 LUT/129 FF/0 DSP. Adds pipe to the sim suite + run_synth; updates utilization.md, BUILDLOG, README.
2026-06-08 feat(rtl): dense base-3 weight packing — 5 ternary/byte (1.6 bits/weight)
    ternary_unpack5.sv: combinational base-3 byte -> 5 ternary 2-bit codes (3^5=243<256). 1.6 bits/weight = the log2(3) optimum, 20pct tighter than 2-bit codes, 5x tighter than INT8 = direct DDR3 traffic cut. export_weights.py adds pack_trits5/unpack_trits5/trit_codes5/pack_row_trits5 (matches RTL). tb_ternary_unpack5.py: exhaustive all-243-bytes bit-exact. Synth: 36 LUT, 0 DSP, 0 CARRY. Suite now dot+gemv+sparse+pipe+unpack. Updates utilization.md, BUILDLOG.
    [ternary_unpack5.sv]
2026-06-08 feat(fpga): Arty A7 on-board top (ternary engine + UART) + build/flash flow
    uart_tx.sv: 8N1 transmitter (sim bit-exact, tb_uart_tx.py). arty_top.sv: computes y=ternary_dot({8x runtime c}, w=0xAA55)=2*c (NOT constant-folded) and streams ASCII 'TN<c><y>' over UART @115200 + heartbeat LEDs. constraints/arty_a7_35.xdc (E3 clk, D10 uart, LEDs). syn/build_bitstream.{tcl,sh} (synth+P&R+bitstream), syn/flash.sh (openFPGALoader), bench/verify_onboard.py (read UART, assert y==2c). Fix: -G param override goes in EXTRA_ARGS (COMPILE_ARGS clobbers cocotb --prefix Vtop). uart added to sim suite.
    [arty_a7_35.xdc, arty_top.sv, uart_tx.sv, verify_onboard.py]
2026-06-08 fix(fpga): correct arty_top weight constant 0xAA55->0xA955 + integration sim
    0xAA55 packs [+1,+1,+1,+1,-1,-1,-1,-1] (sum 0) so y was 0*c=0; the intended [+1,+1,+1,+1,+1,-1,-1,-1] (sum +2, y=2c) packs to 0xA955. Adds tb_arty_top.py (decodes arty_top's UART, checks y==2c) + parameterizes CLKS_PER_BIT for fast sim — this integration test reproduced the bug that 3 separate unit tests missed. Lesson: build weight constants with pack_weights, not by hand. arty added to sim suite.
    [arty_top.sv]
2026-06-08 docs(onboard): ternary engine verified on real Arty A7-35T silicon (16/16 y==2c)
    Flashed arty_top to the physical xc7a35t and confirmed y==2c over UART for 16/16 lines - the multiply-free ternary dot computing correctly in fabric (105 LUT, 0 DSP, 100MHz, WNS +1.924ns). bench/results/onboard.md documents the result + the weight-constant debugging story; BUILDLOG cycle 10; README now leads with the on-silicon proof.
2026-06-08 bench: FPGA power envelope — 63 mW on-chip (~2000x under CPU/GPU)
    Vivado report_power (vectorless, post-route) on arty_top: 0.063W total on-chip (0.062W static + 0.001W dynamic). syn/report_power.{tcl,sh} reproducible. bench/results/power.md establishes the energy denominator: the xc7a35t draws ~1900x less than the 5950X (121W) and ~2700x less than a 3060 (~170W). Phase 0 essentially complete; next decisive step (energy/token head-to-head) needs the GPU.
2026-06-08 feat(rtl): streaming pipelined GEMV — 280 MHz (2.7x combinational), 0 DSP
    ternary_gemv_pipe: row-streamed GEMV driven by the 3-stage ternary_dot_pipe; rows stream 1/cycle, pipeline latency absorbed by valid_out tracking (k-th result = row k). tb_ternary_gemv_pipe.py: 40 GEMVs streamed back-to-back, bit-exact. Synth (xc7a35t): 351 LUT/742 FF/0 DSP/~280MHz - 2.7x the combinational GEMV. The high-clock streaming shape for the on-board datapath. Updates utilization.md, BUILDLOG.
2026-06-08 feat(rtl): ternary_tile — GEMV directly from a base-3 byte burst (mem->engine)
    ternary_tile composes weight_feed -> ternary_gemv_pipe: dense base-3 weight bytes in, y=W*x out, multiply-free, the in-sim memory->compute datapath. tb_ternary_tile.py: 30 trials K=10/M=16, whole matrix streamed as bytes, bit-exact. Synth (xc7a35t): 405 LUT/796 FF/0 DSP/~184MHz. The unit a LiteDRAM front-end will drive on-board. Updates utilization.md, BUILDLOG.
2026-06-08 bench(gpu): RTX 3060 baseline + energy/token head-to-head (same model, GPU loses the ternary advantage)
    Live nvidia-driver-580 install (DKMS, no reboot - nouveau live-swapped; 3060 is pure compute, AMD drives display). CUDA-PyTorch venv. run_gpu.py measures decode tok/s + nvidia-smi power -> J/token. Head-to-head BitNet-2B-4T batch-1: CPU(ternary) 4.62 J/tok @28.4 tok/s, GPU(bf16, dequantized) 3.67 J/tok @23.5 tok/s. The GPU has no ternary datapath -> barely beats the CPU and is slower; FPGA target ~0.25-0.4 J/tok (~10x under GPU) at sub-watt. bench/results/gpu_baseline.md + gpu_baseline/README.md; updates BUILDLOG, README.
2026-06-08 feat(fpga): DDR3 working on the board — LiteX/LiteDRAM, Memtest OK
    Built a LiteX 2026.4 SoC (VexRiscv + LiteDRAM + BIOS) for the Arty A7-35T (syn/litex_arty.sh), flashed it, read the BIOS over UART: SDRAM 256MiB @800MT/s, read-leveling calibrated, Memtest OK, WNS +0.209ns. The MT41K128M16 DDR3 is silicon-proven - the hardest part of the on-board datapath. Build notes (neutral cwd to avoid pkg shadowing; riscv64-unknown-elf + meson/ninja for the BIOS). bench/results/ddr3_onboard.md; updates BUILDLOG, README.
2026-06-08 feat(soc): LiteX SoC integration — ternary_tile as a CSR peripheral (gen-validated)
    soc/ternary_tile_csr.py: LiteX/Migen wrapper exposing the engine via CSRs (x vector, wbyte stream, ctl/start, status/done, rd_addr/rd_data). soc/ternary_arty.py: custom Arty A7-35T SoC (VexRiscv + LiteDRAM + the engine). Gen validated: SoC elaborates, CSR map correct (ternary @0xf0002800), BIOS compiles. Needed integrated_rom_size when constructing BaseSoC directly. Next: full Vivado build + drive a GEMV on-board from the CPU.
2026-06-08 feat(soc): on-board GEMV firmware + test-vector generator (K=8 SoC)
    soc/firmware/main.c: VexRiscv firmware that drives the ternary engine over CSRs (write x, stream base-3 weight bytes, poll done, read y) and checks vs the numpy golden, printing TERNARY_ONBOARD_PASS. soc/firmware/gen_testvec.py emits the C header (same golden + packing as the RTL tests). SoC peripheral set to K=8 so x is a clean 64-bit CSR (ternary_x_write accessor). SoC rebuilding.
2026-06-08 feat(soc): on-board GEMV PASS — engine runs in a RISC-V SoC on silicon, bit-exact
    Flashed the custom LiteX SoC (VexRiscv + LiteDRAM + ternary engine), serial-booted firmware that drives a GEMV from the CPU over CSRs and verifies vs the numpy golden: TERNARY_ONBOARD_PASS (16 rows bit-exact). Full chain on silicon: CPU writes x -> streams base-3 weight bytes -> weight_feed -> unpack5 -> pipelined 0-DSP dot -> y -> CPU reads back. DDR3 calibrated, 100MHz SoC. Capstone of the on-board datapath. bench/results/onboard_soc_gemv.md, soc/README.md; updates BUILDLOG, README.
2026-06-08 docs(research): scaling-feasibility study — scope to one real-width block
    Multi-agent deep-research sweep (23 primary sources, 22 adversarially-verified claims) on scaling the 0-DSP ternary engine toward full BitNet decode on the Arty A7-35T.
    Findings: the LUT-based multiplier-free core is validated SOTA (TeLLMe v2 / TerEffic / T-MAC all store ternary products in LUTs, 0 DSP); batch-1 decode is unanimously bandwidth-bound; a full BitNet 0.73B does NOT fit a 35T (its ternary core alone ~23k LUTs > our 20.8k budget, on a KV260-class part); the host-split (VexRiscv glue + FPGA matmul) is the SOTA-validated architecture. Activation-sparsity (Direction D) was unverified by the literature -> me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
2026-06-08 feat(rtl): tiled K-accumulation GEMV for real-width rows
    Accumulate each output row's dot over NT tiles of K lanes (row width KT=K*NT) through a single ternary_dot, so a fixed K-lane lane computes full-width rows. Weight tiles stream row-major; the activation is stationary (latched on start). Still zero DSP.
    cocotb: 25/25 bit-exact vs the NumPy golden (K=8 NT=4 KT=32 M=16). Foundation for the FFN block's real layer widths.
    [ternary_gemv_tiled.sv]
2026-06-08 feat(models): measure BitNet b1.58 FFN activation sparsity
    Hook all 30 down_proj layers of BitNet-2B-4T over diverse text; report the per-token zero fraction of the squared-ReLU-gated input — the figure the deep-research sweep could not find published for b1.58 (Direction D's premise).
    Result: 59.8% sparse (42-79% by depth), NOT the assumed 85-95%. A real, GPU-unmatchable ~2.5x cut on down_proj traffic and FLOPs; reaching 85-95% would need relu-fication/ProSparse. tools/run_sparsity_remote.sh detaches the run under tmux for the flaky Tailscale link.
2026-06-09 feat(rtl): BRAM-centric streaming ternary GEMV — width-independent, timing met
    The fit-sweep-mandated foundation for the FFN block. Activation in a BRAM read by a sequential address (no NT:1 mux), K-wide multiply-free dot = the pipelined lane, partials accumulate NT-at-a-time into a y BRAM. Weight tiles stream row-major; activation reused per row.
    cocotb bit-exact vs ternary_gemv_golden over 6 configs (incl. odd + single-tile). Synth (xc7a35t, 100MHz): 479 LUT (2.3%), 364 FF (0.9%), 0 DSP, 10 BRAM (20%), WNS +3.5ns (Fmax ~154MHz) — where the register-resident flat-mux tiled was 53% LUT / 79% FF and FAILED timing by -5.9ns. Operands moved from flip-flops to BRAM: ~20x/90x LUT/FF collapse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
    [ternary_gemv_stream.sv]
2026-06-09 feat(models): FFN glue identity — on-chip h_q is integer-only
    Derivation + verification that the down_proj int8 input h_q depends ONLY on the integer N_i = relu(gate_int_i)^2 * up_int_i * w_i: every per-token dequant scale and the RMSNorm normalizer cancel in the final absmax requant (h_q = round(N*127/max|N|)).
    Verified vs the validated ffn_ref on real BitNet-2B-4T layer-0: float-w 100.00% exact match (0 diff); 16-bit fixed-point norm weights 99.99% (<=1 diff). So the float-heavy glue (dequant + RMSNorm sqrt-divide) mostly vanishes on-chip — the FPGA makes h_q with integer multiplies + one per-token reciprocal; the host applies only the final output scale. Justifies an on-chip glue uni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
2026-06-09 feat(sim): full FFN block end-to-end through the streaming GEMV (host-split)
    Engineering call: host-split FFN (FPGA runs the 3 ternary matmuls via ternary_gemv_stream; host does the now integer-only glue) — the research-validated path to a measured number, vs the intricate on-chip glue unit (parked as a documented optimization for after we have an on-board baseline).
    tb_ffn_block.py drives the real RTL GEMV three times (gate -> up -> down) with the host glue (glue_hq) in Python between, checking every integer stage bit-exact vs ffn_ref (gate/up/down) + the glue h_q. PASS over 4 trials. The FFN block datapath is complete and sim-validated end-to-end (ffn_ref itself is validated vs PyTorch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
2026-06-09 feat(soc): stream GEMV as a LiteX CSR peripheral + on-board firmware
    Wraps rtl/ternary_gemv_stream.sv (the BRAM-centric real-width GEMV) as a CSR peripheral for the VexRiscv SoC: nt/m_rows config, activation BRAM load (x_waddr + x_wdata + x_we commit pulse), start, w_tile stream, rd_addr/rd_data, done. K=8 keeps x_wdata a clean 64-bit CSR. Used a dedicated x_we pulse rather than relying on the wide-CSR .re commit semantics.
    ternary_gemv_arty.py builds the SoC (gen validated: integrates, BIOS builds, CSRs generated). main_gemv.c + gen_testvec_gemv.py drive an on-board GEMV and check bit-exact vs the NumPy golden (GEMV_ONBOARD_PASS). Full bitstream build in progress.
2026-06-09 feat(soc): streaming GEMV verified on silicon — GEMV_ONBOARD_PASS, 100MHz, 0.5W
    The scalable BRAM-centric ternary_gemv_stream (the engine the FFN runs gate/up/down on) integrated as a LiteX CSR peripheral in a VexRiscv + LiteDRAM SoC, flashed to the Arty A7-35T, and verified bit-exact from firmware:
    === ternfpga on-board streaming GEMV (K=8 NT=4 M=16 KT=32) ===
    GEMV_ONBOARD_PASS (16 rows bit-exact vs golden)
    All timing constraints met @ 100 MHz; total SoC on-chip power 0.500 W (engine itself 479 LUT/0 DSP/10 BRAM; DDR3+CPU dominate). Honest gap: KT=32 with CPU-streamed weights (not the LiteDRAM roofline) — a measured tok/s + J/token needs the DMA feed at real width. bench/results/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
2026-06-09 feat(sim): down_proj column-sparse activation gather — 56% byte savings at measured sparsity
    Direction D, the column-sparse half. down_proj y[h]=sum_f Wd[h,f]*hq[f] with hq ~60% zero/token; compact the nonzero hq and gather only the matching Wd columns, then run the UNCHANGED dense stream GEMV on the shorter vector. tb_gemv_gather.py: bit-exact vs the dense golden across densities; weight-byte fetch scales with density — at the measured BitNet ~40% active, down_proj fetches ~44% of the dense bytes (56% saved); relu-fied 15% -> 81% saved.
    Per-token unstructured sparsity a GPU's dense/2:4 array can't exploit; the engine is untouched (gather is a feed/DMA concern -> #24). Complements terna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
2026-06-09 feat(soc): host-side FFN glue in C — bit-exact vs golden (FFN_GLUE_C_PASS)
    The integer-only FFN glue the on-board host runs between the gate/up and down GEMVs: per-token int8 activation quant + h_q = round(N*127/max|N|), N = relu(gate_int)^2*up_int*w (dequant/RMSNorm cancel). Subtlety: the exact H (~2^55) is computed in int64 then cast to double, rounding identically to numpy's object->float64, so the ties-to-even requant is bit-exact. test_ffn_glue.c (+ gen_glue_testvec.py) compiles on x86 -> FFN_GLUE_C_PASS, 200 channels bit-exact vs ffn_glue_ref. FFN-relevant host glue done; attention/RoPE/LM-head are full-transformer scope. (Double math on a soft CPU is slow — on-chip glue is the doc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
2026-06-09 feat(rtl): ternary_gemv_bench — on-silicon throughput harness
    Wraps ternary_gemv_stream with a weight BRAM + replay FSM + a hardware cycle counter, so the engine runs at its true 1-tile/cycle rate from resident weights (no CPU/CSR feed bottleneck) and the EXACT compute-cycle count is captured on silicon. cocotb: y bit-exact + cycle_count converges to ~1.0 cyc/tile as the GEMV scales (1.16->1.04->1.01). This is the harness the on-board energy/token measurement rests on: at K<=16 the engine consumes < DDR3 bandwidth (compute-bound), so this measured engine rate IS the on-board throughput; energy/token = cycles/freq x report_power.
2026-06-09 feat(soc): throughput-harness SoC peripheral + firmware
    Wraps rtl/ternary_gemv_bench.sv (engine + resident weight BRAM + replay FSM + hardware cycle counter) as a LiteX peripheral: load x + w_mem via CSRs, pulse run, read back the exact compute cycle_count. main_bench.c loads resident weights, times a 4096-tile GEMV, checks bit-exact, and prints MEASURED tiles/cycles/cyc-per-tile. Gen-validated (integrates, CSR accessors match firmware incl. 64-bit x_wdata); full bitstream building. The on-silicon measurement behind the energy/token number.
2026-06-09 feat(soc): measured on-board throughput — 1.00 cycle/tile on silicon (capstone)
    Built a throughput harness (rtl/ternary_gemv_bench.sv: engine + resident weight BRAM + replay FSM + hardware cycle counter), wrapped it as a LiteX peripheral, flashed the Arty, and timed a 3969-tile GEMV from firmware:
    BENCH_ONBOARD_PASS (63 rows bit-exact)
    MEASURED tiles=3969 cycles=3974 cyc_per_tile=1.00 (K=8 @100MHz)
    The multiply-free 0-DSP engine sustains 1.00 cycle/tile on silicon = 800 M ternary-MAC/s, bit-exact. SoC power 0.489 W, 0 DSP in the engine. Derived: a real BitNet-2B FFN block (53.1M ternary weights) = 66.4 ms -> ~32 mJ (SoC) vs the 3060's ~61 mJ/FFN-block (extrapolated from its measure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
2026-06-09 docs(phase3): research-grounded plan — full-model decode loop + measured J/token
    Captures the deep-research verdict (complete as portfolio, not as paper/product; the gap is specific and closeable), the Phase-3 objective (measured full-model J/token on the $130 board), the build decomposition (#28-#33: DMA roofline -> attention -> single layer -> decode loop -> measured energy -> sparsity characterization), the two risks the build is designed to expose (single-channel DDR3 ceiling; whether ~60% sparsity stays unstructured at scale), the BitNet ~0.7B model target (fits 256MB DDR3, matches TeLLMe's 0.73B), and the power decision (Vivado estimate now, live deferred).
2026-06-09 feat(soc): DDR3 read-bandwidth instrument (roofline, Risk-1 test)
    A hardware LiteDRAMDMAReader on a native crossbar port streams sequential words from DDR3 while a cycle counter measures the run -> the CPU computes sustained GB/s (the TRUE roofline, not the BIOS Memspeed CPU memcpy). Batch-1 decode is bandwidth-bound (every weight streamed once per token), so this number caps full-model tok/s and sets the J/token floor. main_dmabw.c reports bw + the implied 0.7B tok/s ceiling. Gen-validated (native read port integrates, CSR accessors match firmware); bitstream building. First Phase-3 increment (#28) and the fail-fast on whether single-channel DDR3 sinks the energy thesis.
    [main_dmabw.c]
2026-06-09 feat(models): BitNet attention golden — cosine 1.0 vs real model
    models/attn_ref.py: NumPy golden for BitNet attention, reusing the ffn_ref bitlinear (int8-absmax -> ternary matmul -> dequant) for the q/k/v/o projections + host glue (RoPE theta=500000, GQA 20q/5kv heads x128, causal softmax, attn_sub_norm before o_proj). inspect_bitnet_attn.py pinned the exact structure from the real model (attn_sub_norm is the 'diff with Llama'). validate_attn.py vs microsoft/BitNet-b1.58-2B-4T: cosine 1.000000, mean rel err 5e-06, ATTN_VALIDATE_PASS. The FPGA does the four ternary projection GEMVs (reusing the proven engine); scores/softmax/RoPE/sub-norm are VexRiscv host glue. First #29 sub-step (golden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
2026-06-09 feat(firmware): BitNet attention host glue — ATTN_GLUE_C_PASS
    soc/firmware/attn_glue.h: the VexRiscv glue between the q/k/v and o_proj FPGA matmuls, as one autoregressive decode step — dequant q/k/v, RoPE (theta=500000), KV-cache append, per-head causal scores/softmax, a@V, attn_sub_norm, int8 requant. Validated native vs attn_ref.py (test_attn_glue.c + gen_attn_testvec.py): ATTN_GLUE_C_PASS, cosine 1.0000000, max rel err 2.5e-06 over per-token decode steps with a growing KV cache. Float glue (softmax/RoPE) so it matches to float precision, not bit-exact (unlike the integer-only FFN glue). The four projections reuse the silicon-proven ternary_gemv_stream — validated end-to-end at #30.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
2026-06-09 feat(models): full decoder-layer golden — LAYER_VALIDATE_PASS cosine 1.0
    models/layer_ref.py composes the attention (#29) + FFN (Phase 2) goldens with the two RMSNorms and residuals (LLaMA-style pre-norm: h = x + attn(input_ln(x)); y = h + ffn(post_ln(h))). validate_layer.py vs microsoft/BitNet-b1.58-2B-4T layer 0: cosine 1.000000, mean rel err 8e-07, LAYER_VALIDATE_PASS. The complete per-layer oracle for the on-board single-layer test (#30) and the decode loop (#31): FPGA runs the 7 ternary GEMVs, VexRiscv runs the norms/residuals/RoPE/softmax/requant glue.
2026-06-09 feat(firmware): soft-float libm + glue-cycle bench harness
    This LiteX/picolibc build ships no libm (no exp/cos/sin/sqrt/pow/floor/lrint), so soc/firmware/fw_mathf.h provides them (polynomial/Newton, ~1e-7, standard names) for the on-device transformer glue — reused by the decode loop (#31). soc/build_fw.sh builds a firmware against an existing LiteX bitstream and links the correct rv32 libgcc.a (soft-float __truncdfsf2/__extendsfdf2; resolved as a literal path since the recipe's $(CPUFLAGS) is empty). bench_glue.c times one BitNet-2B layer of host glue (RMSNorm + attention decode step + FFN glue) at real width via timer0 to measure the VexRiscv glue cost (the unknown in cycles/layer; engin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
    [bench_glue.c, fw_mathf.h]
2026-06-09 wip(firmware): glue-cycle bench infra (libm, DRAM buffers, rdcycle, libgcc link)
    Resolved a chain of bare-metal blockers: this LiteX/picolibc ships no libm (fw_mathf.h: fw_-prefixed soft-float exp/cos/sin/sqrt/pow/log/floor/lrint, mapped to std names in-firmware to avoid pulling tinystdio's float-printf); the rv32 libgcc (soft-float __truncdfsf2/__extendsfdf2) is linked as a literal path by build_fw.sh; the ~0.8MB KV cache + buffers moved to a high DDR3 address (.bss overflowed the small sram); timing switched to rdcycle. KNOWN-BLOCKER: a %d printf still traps a few chars in once the glue/fw_mathf is linked (a no-arg printf is fine) — next: install a trap handler to read mcause/mepc, or me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
    [bench_glue.c, fw_mathf.h]
2026-06-09 wip(firmware): glue bench uses uart_write+timer0 (on-board glue timing parked)
    Switched I/O to a manual uart_write integer formatter and timing to timer0 (BIOS pattern), ruling out printf/rdcycle as the cause: the heavy soft-float binary (libgcc-linked, glue+fw_mathf) still halts output ~6 chars in, where the lean main_dmabw prints fine — a toolchain/runtime issue in the heavy firmware (likely the injected rv32 libgcc link / RWX segment). Parking the on-board glue CYCLE count as a documented limitation; composing the full-model number from the MEASURED engine rate (1 cyc/tile) + roofline + an honest glue analysis instead. The glue is sim-validated (ATTN_GLUE_C_PASS); only its on-silicon ti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
    [bench_glue.c]
2026-06-09 feat(bench): full-model energy/token projection from measured primitives
    Layer golden validated cosine 1.0 (LAYER_VALIDATE_PASS). Composed full-model J/token from the on-silicon primitives (engine 1 cyc/tile, DDR3 1.42 GB/s, 0.489 W) x real BitNet-2B dims: 2.41G ternary weights/token -> 301.5M engine cycles -> ~3.0s -> ~1.47 J/token engine compute, ~2.5x under the RTX 3060's measured 3.67 J/tok (~2.9x with the measured down_proj gather); energy is ~K-invariant so widening K buys throughput not energy. Honest: the host-glue on-board cycle count is unmeasured (heavy soft-float firmware halts UART early — toolchain wall, parked); glue is sim-validated (ATTN_GLUE_C_PASS); the proven integer-on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
2026-06-09 feat(bench): Risk-2 sparsity-structure verdict — unstructured (Phase 3 done)
    models/sparsity_structure.py probes BitNet-2B down_proj inputs (62 tok x 30 layers): mean 59.5% zero but 93.9% data-dependent channels, token-to-token Jaccard 0.42, static N:M captures only 68.9% of zeros -> VERDICT UNSTRUCTURED, the on-fabric gather differentiator holds (a TENET-style N:M would still fetch ~31% of the zero columns). 28/30 layers >93% data-dependent. sparsity_structure.md + figure. Both Phase-3 risks now resolve POSITIVELY (Risk-1 DDR3 survives, Risk-2 unstructured). gpu_baseline.md gains the engine-based head-to-head (~1.47 J/tok vs 3060 3.67, ~2.5x; honest TeLLMe v2 / FlightLLM context); README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
2026-06-09 feat(models): fixed-point attention glue golden — no-libm LUTs (cosine 1.0)
    models/glue_fixed_ref.py: the attention glue with its only transcendentals (RoPE cos/sin, softmax exp) replaced by precomputed LUTs (Q15 cos/sin, 4096-entry exp), and attn_sub_norm's 1/sqrt left to cancel in the o_proj requant (the ffn_glue integer trick). Self-test vs the float golden (attn_ref): cosine 0.999999, rel err 5.4e-04 -> FIXED_GLUE_GOLDEN_PASS. De-risks Phase 4: the on-device glue needs NO libm (static LUTs + integer/fixed-point), so the firmware binary stays lean and should not hit the heavy-soft-float UART trap that parked the Phase-3 measurement. Next: port to C (#35), measure on-board (#36), fully-m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
2026-06-09 feat(firmware): pure-integer glue bench — glue MEASURED on silicon (19.4M cyc/layer)
    The Phase-3 firmware wall was a MISSING irq_setie: LiteX uart_write is IRQ-driven, so without interrupts the TX ring stalls ~8 chars in. main_dmabw/main_bench had the irq block; the bench firmwares dropped it (NOT float/libm/timer, which were red herrings). With it restored, the pure-integer glue (RoPE/softmax via Q15 LUTs from gen_glue_luts.py, RMSNorm+FFN via integer cancellation, no float/libm) runs clean and times one BitNet-2B layer of glue with timer0: norm_x2=544857 rope=80425 attn=16213542 ffn=2583703 -> GLUE_INT_PER_LAYER=19.42M cycles. Finding: glue ~2.2x the engine's 8.68M -> the naive host-spli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
    [bench_glue_int.c, gen_glue_luts.py]
2026-06-09 feat(bench): fully-measured J/token — glue-bound verdict (Phase 4 done)
    Both cycle terms now measured on silicon: layer = engine 8.68M + glue 19.42M = 28.1M cyc -> 30 layers + LM-head = 884M cyc/token -> 8.84s -> ~4.32 J/token. The 0-DSP engine is ~2.5x under the RTX 3060 (1.47 J/tok) but the naive host-split system is ~1.2x WORSE (4.32 vs 3.67): the glue is 2.2x the engine and 83% of it is host-side attention (scores/softmax/a@V), DRAM-latency-bound on the cacheless VexRiscv. Decisive architecture lesson (matches SOTA): attention must live on the fabric (KV in BRAM) -> removes the 16.2M term -> engine-bound -> ~1.47 J/tok. glue_measured.md + updated full_model_energy.png + BUILDLOG (n/o/p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
2026-06-09 feat(models): integer attention-unit oracle — ATTN_UNIT_ORACLE_PASS (cosine 0.999)
    models/attn_unit_ref.py: the bit-exact integer recipe the hardware attention unit will do for one query vs a KV cache — int16 scores (dot q.k), softmax via a programmable RIGHT SHIFT into the Q15 exp LUT (idx=(max-score)>>score_shift, no multiply for the temperature), integer a@V normalized by sum(e). vs float softmax-attention: cosine 0.999338 (score_shift=26). The shift-based softmax is the key RTL-friendly find. This is the cocotb oracle for rtl/attention_unit.sv (#39). Closes #38.
2026-06-09 feat(rtl): attention_unit.sv on-fabric attention — bit-exact, ~98x vs host
    rtl/attention_unit.sv: one query vs a BRAM-resident KV cache (scores int16 MAC -> shift+exp-LUT softmax -> a@V), outputs num[d]+sum_e (divider-free; ctx=num/sum is a trivial host step). cocotb (sim/tb_attention_unit.py, make -C sim attn): bit-exact vs models/attn_unit_ref (num[d] + sum_e), ATTENTION_UNIT_PASS. Measured 8232 cyc/query at T=32 (~1 MAC/cycle) -> ~165K cyc/layer (x20 heads) vs the measured 16.2M host attention = ~98x collapse (~49x at the host bench's T=64). This is the term that made the system glue-bound. Fixed: exp LUT[0]=32768 overflowed signed-16 (-> -32768) flipping the max key; clip oracle LUT to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
    [attention_unit.sv]
2026-06-09 feat: on-fabric attention flips system to ~1.8x under GPU (Phase 5 done)
    attention_unit synthesizes on the 35T (24% LUT / 4 DSP / 18.5 BRAM, Fmax ~86MHz; attention_unit_syn.md). Recompute with on-fabric attention replacing the 16.2M host term: glue/layer 19.4M->3.5M, layer 28.1M->12.2M, token ~407M cyc -> ~1.99 J/token. System FLIPS from glue-bound (4.32, 1.2x worse than 3060) to ENGINE-DOMINANT (~1.99, ~1.8x under) -- the 0-DSP engine's energy win realized at the system level (engine = 71% of the layer). Largest remaining glue = FFN 2.58M (next: FFN-glue on-fabric -> ~1.47 / 2.5x). glue_measured.md Phase-5 section + full_model_energy.png + BUILDLOG (q/r) + README. Engine+glue measured on si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
2026-06-09 feat(soc): attention_unit LiteX peripheral + firmware (on silicon)
    soc/attention_unit_csr.py wraps rtl/attention_unit.sv (T_MAX=64 for BRAM budget) as a CSR peripheral: load q/KV/exp-LUT, pulse start, read num[d]+sum_e + hardware cycle_count. soc/attention_unit_arty.py SoC builder. main_attn.c + gen_testvec_attn.py: load + run + check bit-exact vs the oracle (ATTN_ONBOARD_PASS) + read silicon-measured attention cycles. Gen-validated (CSR accessors match); bitstream building. Completes attention's PyTorch->sim->silicon chain (the FFN already had it). Note: OOC synth WNS was -1.7ns@100MHz; will check post-P&R timing on the LiteX build.
2026-06-09 feat: attention_unit on silicon — bit-exact, ~49x collapse measured (Phase 6 done)
    attention_unit integrated as a LiteX peripheral + run on the physical Arty A7-35T: ATTN_ONBOARD_PASS (128 num + sum_e bit-exact vs the oracle), MEASURED 16456 cyc/query @ T=64 D=128 (sim 16384; ~1 MAC/cycle confirmed on hardware) -> ~329K cyc/layer vs the measured 16.2M host attention = ~49x collapse, silicon-measured (~98x at T=32). Attention now has the full PyTorch->sim->silicon chain (like the FFN); the Phase-5 ~1.8x-under-GPU system result's key new term is silicon-confirmed. Timing honesty: post-P&R WNS -1.268ns@100MHz (model ~89MHz) but ran bit-exact @100MHz at nominal conditions; a pipeline register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
2026-06-09 feat: on-fabric FFN-glue unit (relu^2*up*w + int8 requant), bit-exact, ~165x
    rtl/ffn_glue_unit.sv: the last big host glue term on the fabric. gate_int/up_int/w_q in BRAM; 2 passes (compute N=relu(gate)^2*up*w_q + track max|N|; one reciprocal recip=(127<<R)/max|N| via a restoring divide, R=msb(max|N|)+25; requant h_q=round(|N|*recip>>R)*sign). Outputs h_q int8 + max|N|. Divider-free per channel. models/ffn_glue_unit_ref.py integer oracle (recip-round matches exact round-half-up 100%). cocotb tb_ffn_glue_unit BIT-EXACT (512 h_q + amaxN), 2.26 cyc/channel -> ~15.6K cyc/layer vs measured host 2.58M = ~165x collapse. Bug found+fixed: readback was 2-stage (hq_rd->rd_data) vs the tb's 2-edge wait -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
    [ffn_glue_unit.sv]
2026-06-09 docs: ffn_glue_unit synthesis on 35T (7% LUT / 1% FF / 40% BRAM / 19 DSP)
    Fits comfortably after the hqmem->BRAM fix (first synth 115% LUT/134% FF: hqmem was a 6912x8 FF array + decoder because write/read were in different always blocks; same template as read -> simple-dual-port BRAM). WNS -42.7ns@100MHz (Fmax ~19MHz unpipelined: the 1-cycle relu->g^2->*up->*w->*recip->barrel-shift chain; ~6-stage pipeline closes 100MHz at the same cycle count, immaterial as FFN glue is ~0.16% of the layer). Closes #46.
2026-06-09 feat: FFN glue on-fabric -> ~1.62 J/token, ~2.3x under GPU (Phase 7 done)
    With both attention and FFN glue on-fabric, glue/layer 19.42M->0.97M, layer 28.1M->9.65M, token ~330M cyc -> ~1.62 J/token -> ~2.3x under the RTX 3060 (from 1.99/~1.8x). The engine is now 90% of the layer; the 2x RMSNorm (0.54M) is the largest remaining glue -> a norm unit is the last step toward the 1.47 J/tok / 2.5x engine bound. full_model_energy.png now shows the full progression (4.32 host-split -> 3.67 GPU -> 1.99 +attn -> 1.62 +FFN-glue -> 1.47 engine bound). glue_measured.md Phase-7 section + BUILDLOG (t/u) + README + memory. Engine+host-glue+attention silicon-measured; FFN glue sim/synth-backed. Closes #47 / P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
2026-06-09 perf(ffn_glue_unit): pipeline to 8 stages, WNS -42.7ns -> -1.9ns (silicon-ready)
    Pipelined the single-cycle compute (relu->g^2->*up->*w->*recip->add->shift->clip) into 8 stages, valid+index+operands travelling per stage. Closed timing in 3 steps: -42.7 (1-cycle) -> -8.9 (pipelined) -> -3.2 (registered the requant scale Rsh/half, taking the msb priority encoder off the per-cycle path) -> -1.9 (split the 122-bit add from the barrel shift). -1.9ns OOC matches the attention unit's -1.7ns (which ran bit-exact at 100MHz on silicon). Still bit-exact (FFN_GLUE_UNIT_PASS), same cycle count (1174, ~162x). 8% LUT / 2% FF / 40% BRAM / 19 DSP. ffn_glue_unit_syn.md updated. Closes #48.
2026-06-09 feat(soc): ffn_glue_unit LiteX peripheral + firmware (on silicon)
    soc/ffn_glue_csr.py wraps rtl/ffn_glue_unit.sv (F_MAX=6912) as a CSR peripheral: load gate/up/w, pulse start, read h_q[f] int8 + max|N| (3 words) + hardware cycle_count. soc/ffn_glue_arty.py SoC builder (FFN-glue 20 BRAM + SoC 27 = 47 < 50, fits the 35T). main_ffnglue.c + gen_testvec_ffnglue.py: load + run + check bit-exact vs the oracle (FFNGLUE_ONBOARD_PASS, F=6912 so cycles = per-layer) + read silicon-measured cycles. Gen-validated; bitstream building. Closes #49.
2026-06-09 feat: FFN glue on silicon — bit-exact, 13974 cyc/layer measured (184x)
    Ran ffn_glue_unit on the physical Arty A7-35T: FFNGLUE_ONBOARD_PASS (6912 h_q + max|N| bit-exact vs the oracle), MEASURED 13974 cyc/layer (vs the sim's 15.8K naive extrapolation; the real F=6912 amortizes the per-pass overhead) = 184x collapse vs the 2.58M host FFN glue. Post-P&R WNS -1.615ns@100MHz but ran bit-exact at nominal (like attention's -1.27ns). Firmware fix: poll cycle_count-stability instead of the 1-cycle done pulse (the slow CPU poll missed it -> cosmetic TIMEOUT; the unit completed correctly). FFN glue now PyTorch->sim->silicon. Closes #50.
    [main_ffnglue.c]
2026-06-09 docs: FFN glue silicon-measured (13974 cyc/layer, 184x) — Phase 8 done
    FFN glue now PyTorch->sim->silicon: 3 of 4 system cycle terms silicon-measured (engine, attention, FFN glue); only the 2x RMSNorm (0.54M) + the fully-integrated loop remain projected. System J/token unchanged ~1.62 (~2.3x under GPU) — Phase 8 hardened the largest derived term to measured. ffn_glue_onboard.md + glue_measured.md (Phase-8 section) + BUILDLOG (v/w) + README + memory. Honest frontier documented: the fully-integrated decode loop (27+18+20=65 BRAM > 50) needs F-tiling or a bigger board; each accelerator + SoC fits and is silicon-proven individually. Closes #51 / Phase 8.
2026-06-09 feat(soc): engine+ffn_glue co-resident SoC + cooperation firmware (capstone)
    soc/coresident_arty.py instantiates BOTH the ternary engine (TernaryGemvStream) and the ffn_glue_unit (F_MAX=6912) in one Arty A7-35T SoC — the integrated capstone (two custom accelerators co-resident). main_coresident.c + gen_testvec_coresident.py: a small FFN (hidden=64, INTER=32) where the engine computes the gate/up ternary GEMVs and its int32 outputs feed ffn_glue (relu^2*up*w + int8 requant), h_q read back bit-exact end-to-end (COMBINED_ONBOARD_PASS). Reuses ternary_ref packing + the glue oracle. Gen-validated (eng_* + ffng_* accessors); bitstream building. Closes #52.
2026-06-09 feat: engine+ffn_glue co-resident + cooperating on silicon (Phase 9 done)
    COMBINED_ONBOARD_PASS: the ternary engine + full-width ffn_glue_unit instantiated in one Arty A7-35T SoC, run cooperating on the physical board — engine computes gate/up ternary GEMVs (0 row mismatches), int32 outputs feed ffn_glue (relu^2*up*w + int8 requant), 32 h_q bit-exact end-to-end. The first multi-accelerator computation on the board. Fit 31% LUT / 12% FF / 45/50 BRAM / 23 DSP (full-width ffn_glue + engine + SoC); WNS -1.713ns@100MHz, ran bit-exact nominal. Proves the custom accelerators co-reside AND hand off data on real silicon; pins the frontier (a pair fits at 45 BRAM, +attention=63>50 needs tiling/bigge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
